NewsanLab/ArchiRFID/Img/Dispositivo.jpg

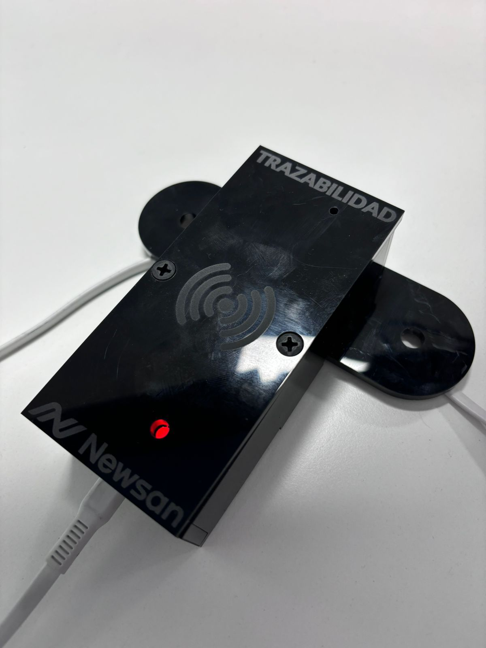
Img/Dispositivo.jpg
