NewsanLab/ArchiRFID/Img/EsquemaRFID.png

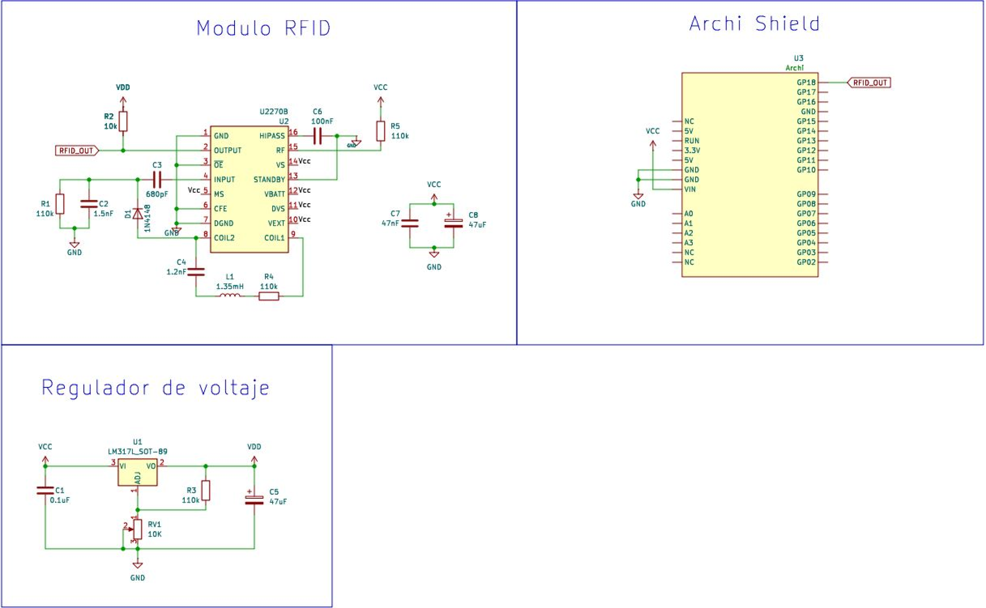
Img/EsquemaRFID.png
