NewsanLab/ArchiRFID/Img/Tarjetas.png

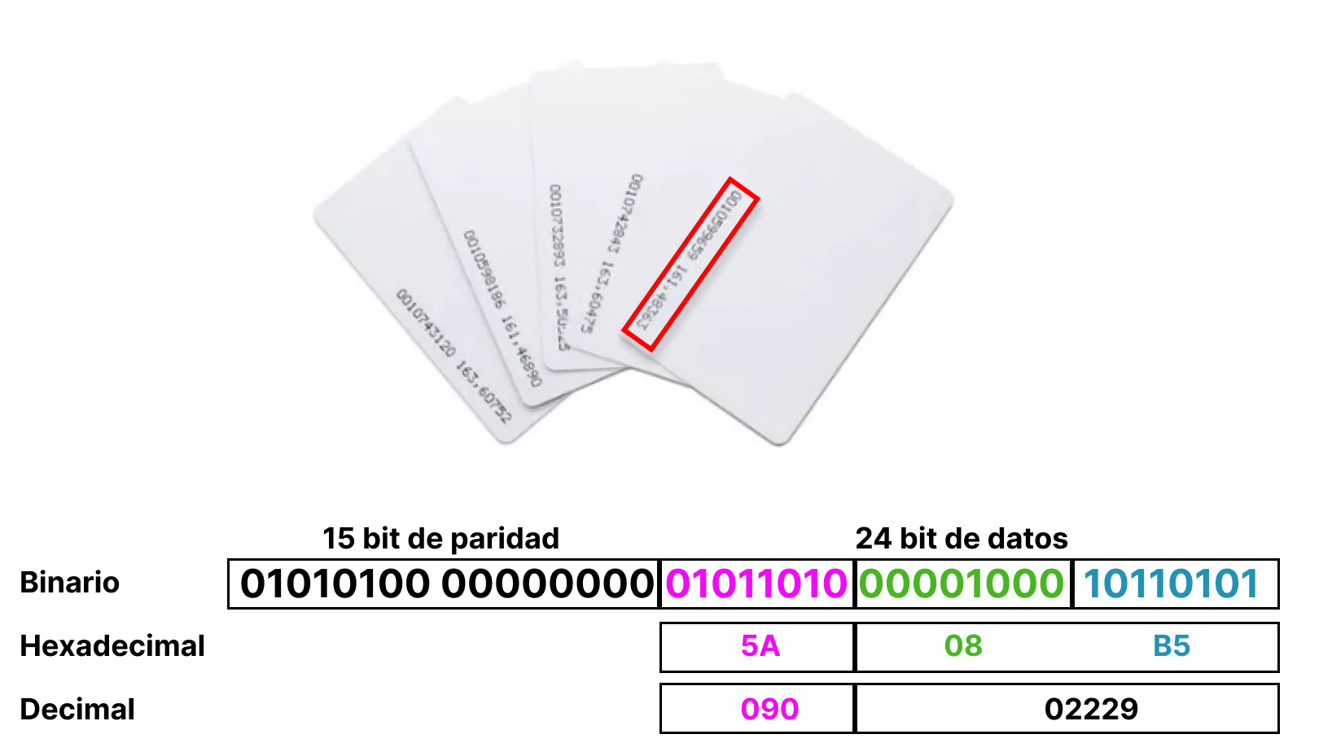
Img/Tarjetas.png
