NewsanLab/ArchiRFID/Hardware/ArchiRFID_Sch.pdf

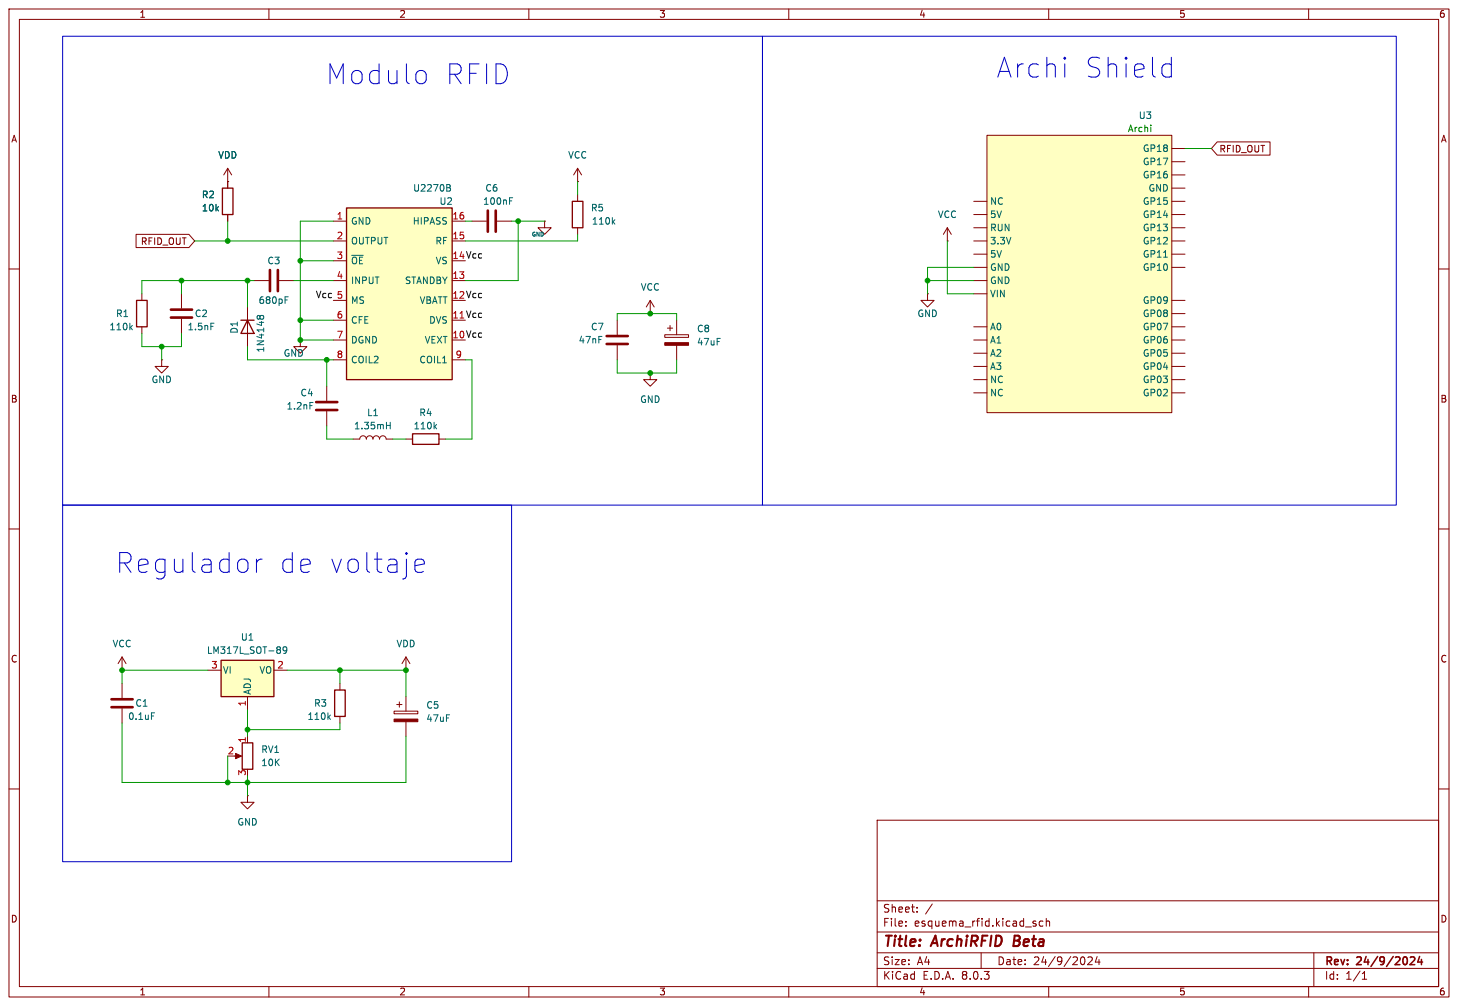
[picture p6: page 1]

File: esquema_rfid.kicad_sch Sheet: /
Id: 1/1 Title: ArchiRFID Beta
